Punkoivan/zigbee-remote-controller/case/grid_test.3mf

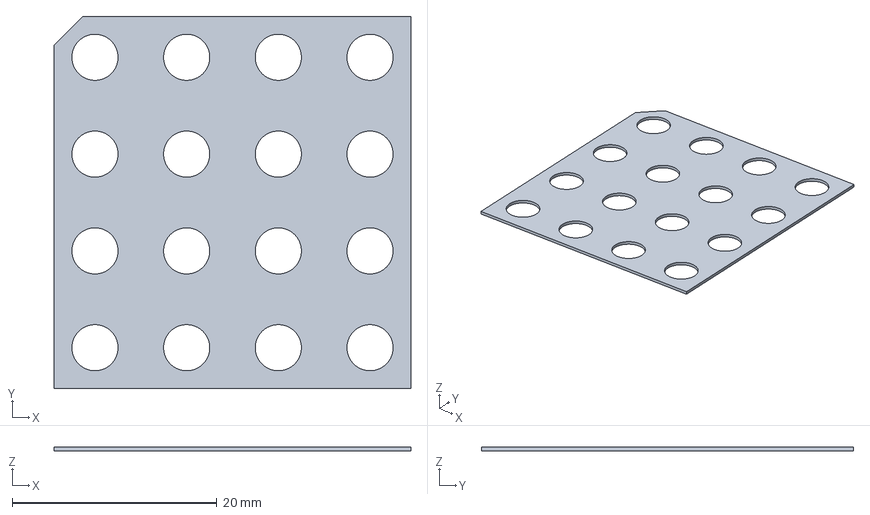
[picture p1: CAD file, 2026-10-19]
case/grid_test.3mf
34.9 x 36.4 x 0.4 mm
