Punkoivan/zigbee-remote-controller/case/case_lid.3mf

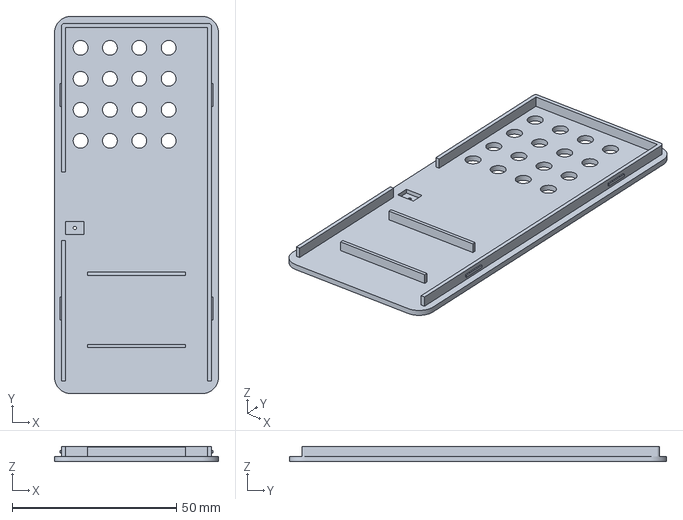
[picture p2: CAD file, 2026-10-19]
case/case_lid.3mf
50.0 x 115.0 x 4.60 mm
