Punkoivan/zigbee-remote-controller/case/case_tray.3mf

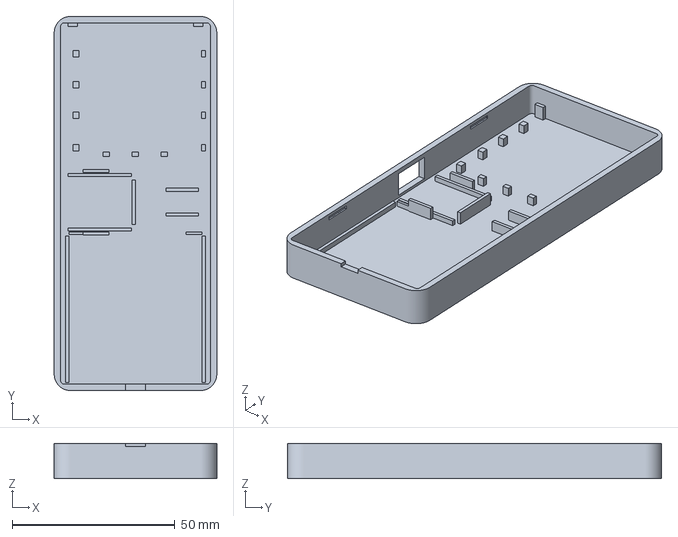
[picture p3: CAD file, 2026-10-19]
case/case_tray.3mf
50.0 x 115.0 x 10.8 mm
