Punkoivan/zigbee-remote-controller/case/remote_case.FCStd

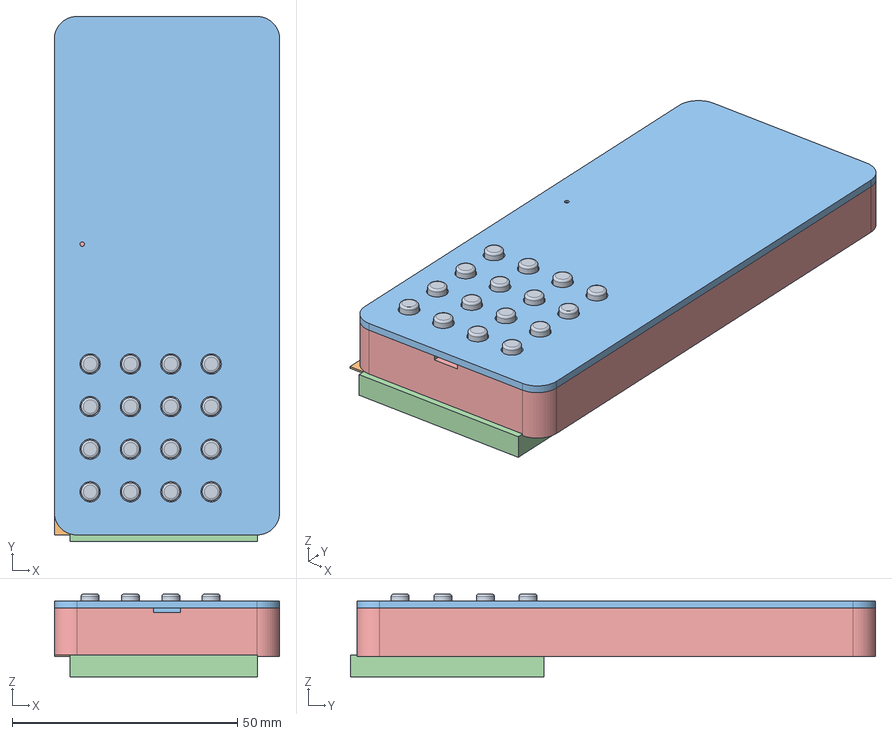
[picture p4: CAD file, 2026-10-19]
case/remote_case.FCStd
50.0 x 116.5 x 18.4 mm
Caps
GridTest
Lid
TestPlate
Tray
