Punkoivan/zigbee-remote-controller/case/keycap_row4.3mf

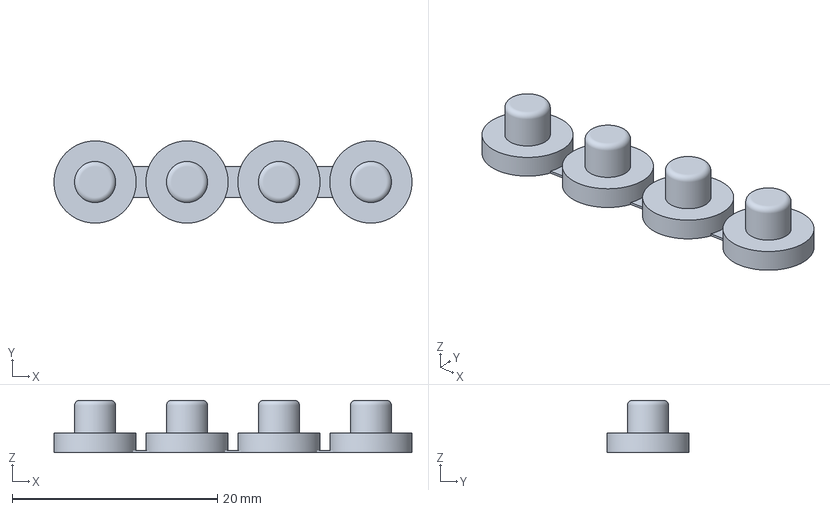
[picture p5: CAD file, 2026-10-19]
case/keycap_row4.3mf
34.8 x 8.00 x 5.10 mm
