Punkoivan/zigbee-remote-controller/(commit log)

2026-10-19 Zigbee keypad remote: firmware, case model and tools
    XIAO MG24 + 4x4 keypad remote for Home Assistant (ZHA): firmware
    (Silicon Labs Arduino core, Zigbee), FreeCAD case generator with
    exported 3MF files, and a Home Assistant websocket helper.
    [case_lid.3mf, case_tray.3mf, grid_test.3mf, keycap_row4.3mf, remote_case.FCStd]
2026-10-20 Sleepy end device firmware on Simplicity SDK
    The Arduino Zigbee library keeps the receiver on, which drained the
    500 mAh battery in about two days. firmware-sisdk/ is a Simplicity SDK
    2026.6 project based on the Z3 Switch sample that joins as a sleepy end
    device and keeps the same ZHA interface (endpoint 10/11 move_to_level,
    Power Configuration battery reports, OTA version announce).
    - keypad rows on port C can't wake EM2, so they are polled by a 50 ms
    sleeptimer while idle
    - stay in short poll for 60 s after joining so ZHA can interview
    - RF switch power, +10 dBm TX, external SPI flash put to deep sleep
    - README: build and flash instructions, board notes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
    [app.c, battery.c, battery.h, board.c, board.h, end-device-support-config.h, keypad.c, keypad.h]
2026-10-21 README: battery result of the sleepy firmware
